joelrader/linux-business-card/readme.md

# linux-business-card
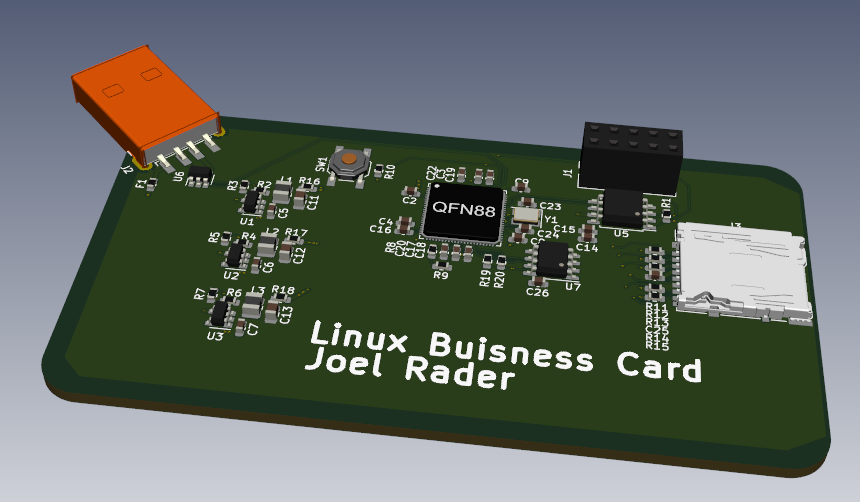
[picture p1: media/board.png]


A business card that runs Linux! It has a strong focus on security and privacy.

## Components
- F1C100s is the main application processor
- ATECC608A used as the crypto chip
- Micro SD card slot
- Flash memory
