joelrader/linux-business-card/electronics/readme.md

# Electrical Design
The main AP is an Allwinner F1C100s.

## Power Rails

VCC-IO: 3.3V @ ?A
TV_AVCC: 3.3V @ ?A
Avcc: 2.8V @ ?A
VCC_DRAM: 2.5V @ ?A
VDD_CORE: 1.1V @ ?A

## Components
SMPS
    - JW5211
        - Looks decent
