joelrader/linux-business-card/electronics/board/step/QFN88.stp

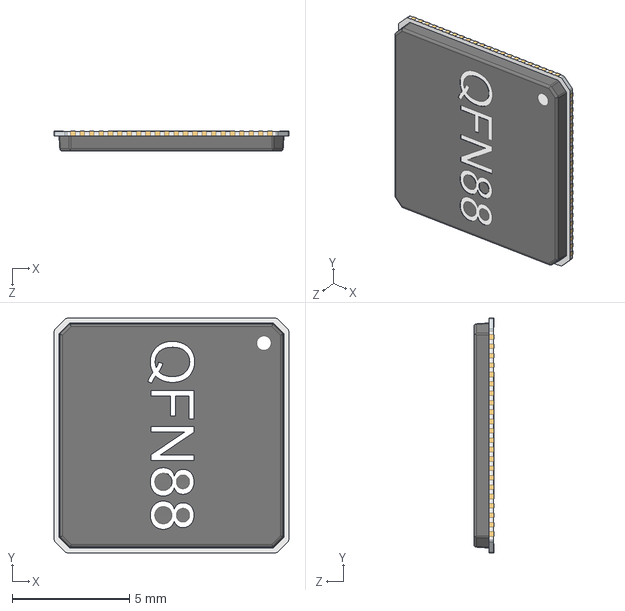
[picture p2: CAD file, 2021-07-21]
electronics/board/step/QFN88.stp
10.0 x 10.0 x 0.87 mm
