joelrader/linux-business-card/electronics/board/step/DM3AT-SF-PEJM5.stp

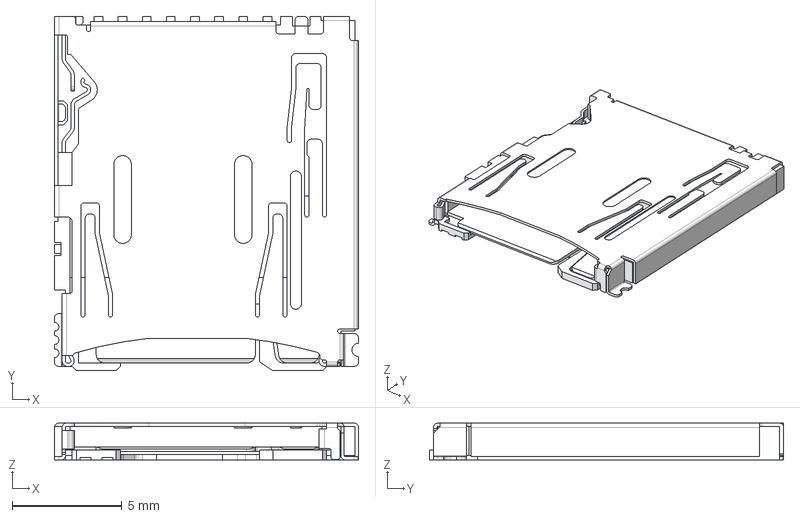
[picture p3: CAD file, 2021-07-21]
electronics/board/step/DM3AT-SF-PEJM5.stp
13.8 x 16.2 x 1.68 mm
