joelrader/linux-business-card/electronics/board/step/1001-011-01101.igs

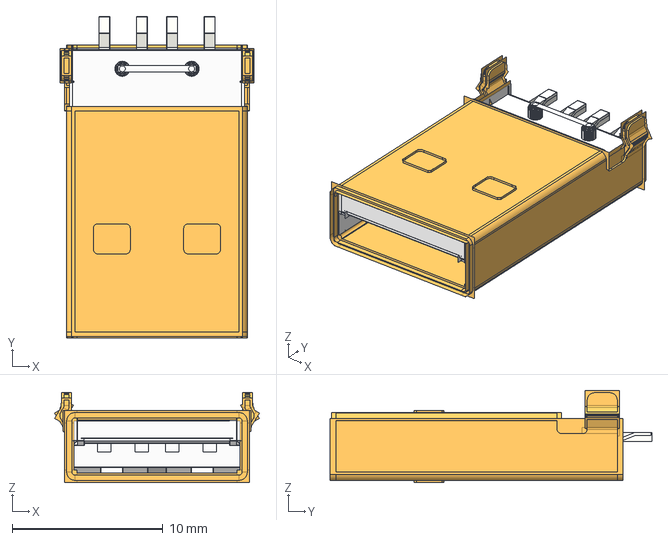
[picture p4: CAD file, 2021-07-21]
electronics/board/step/1001-011-01101.igs
13.6 x 21.4 x 6.12 mm
