joelrader/linux-business-card/electronics/board/board.kicad_pcb

## KiCad design electronics/board/board.kicad_pcb (2021-07-27)

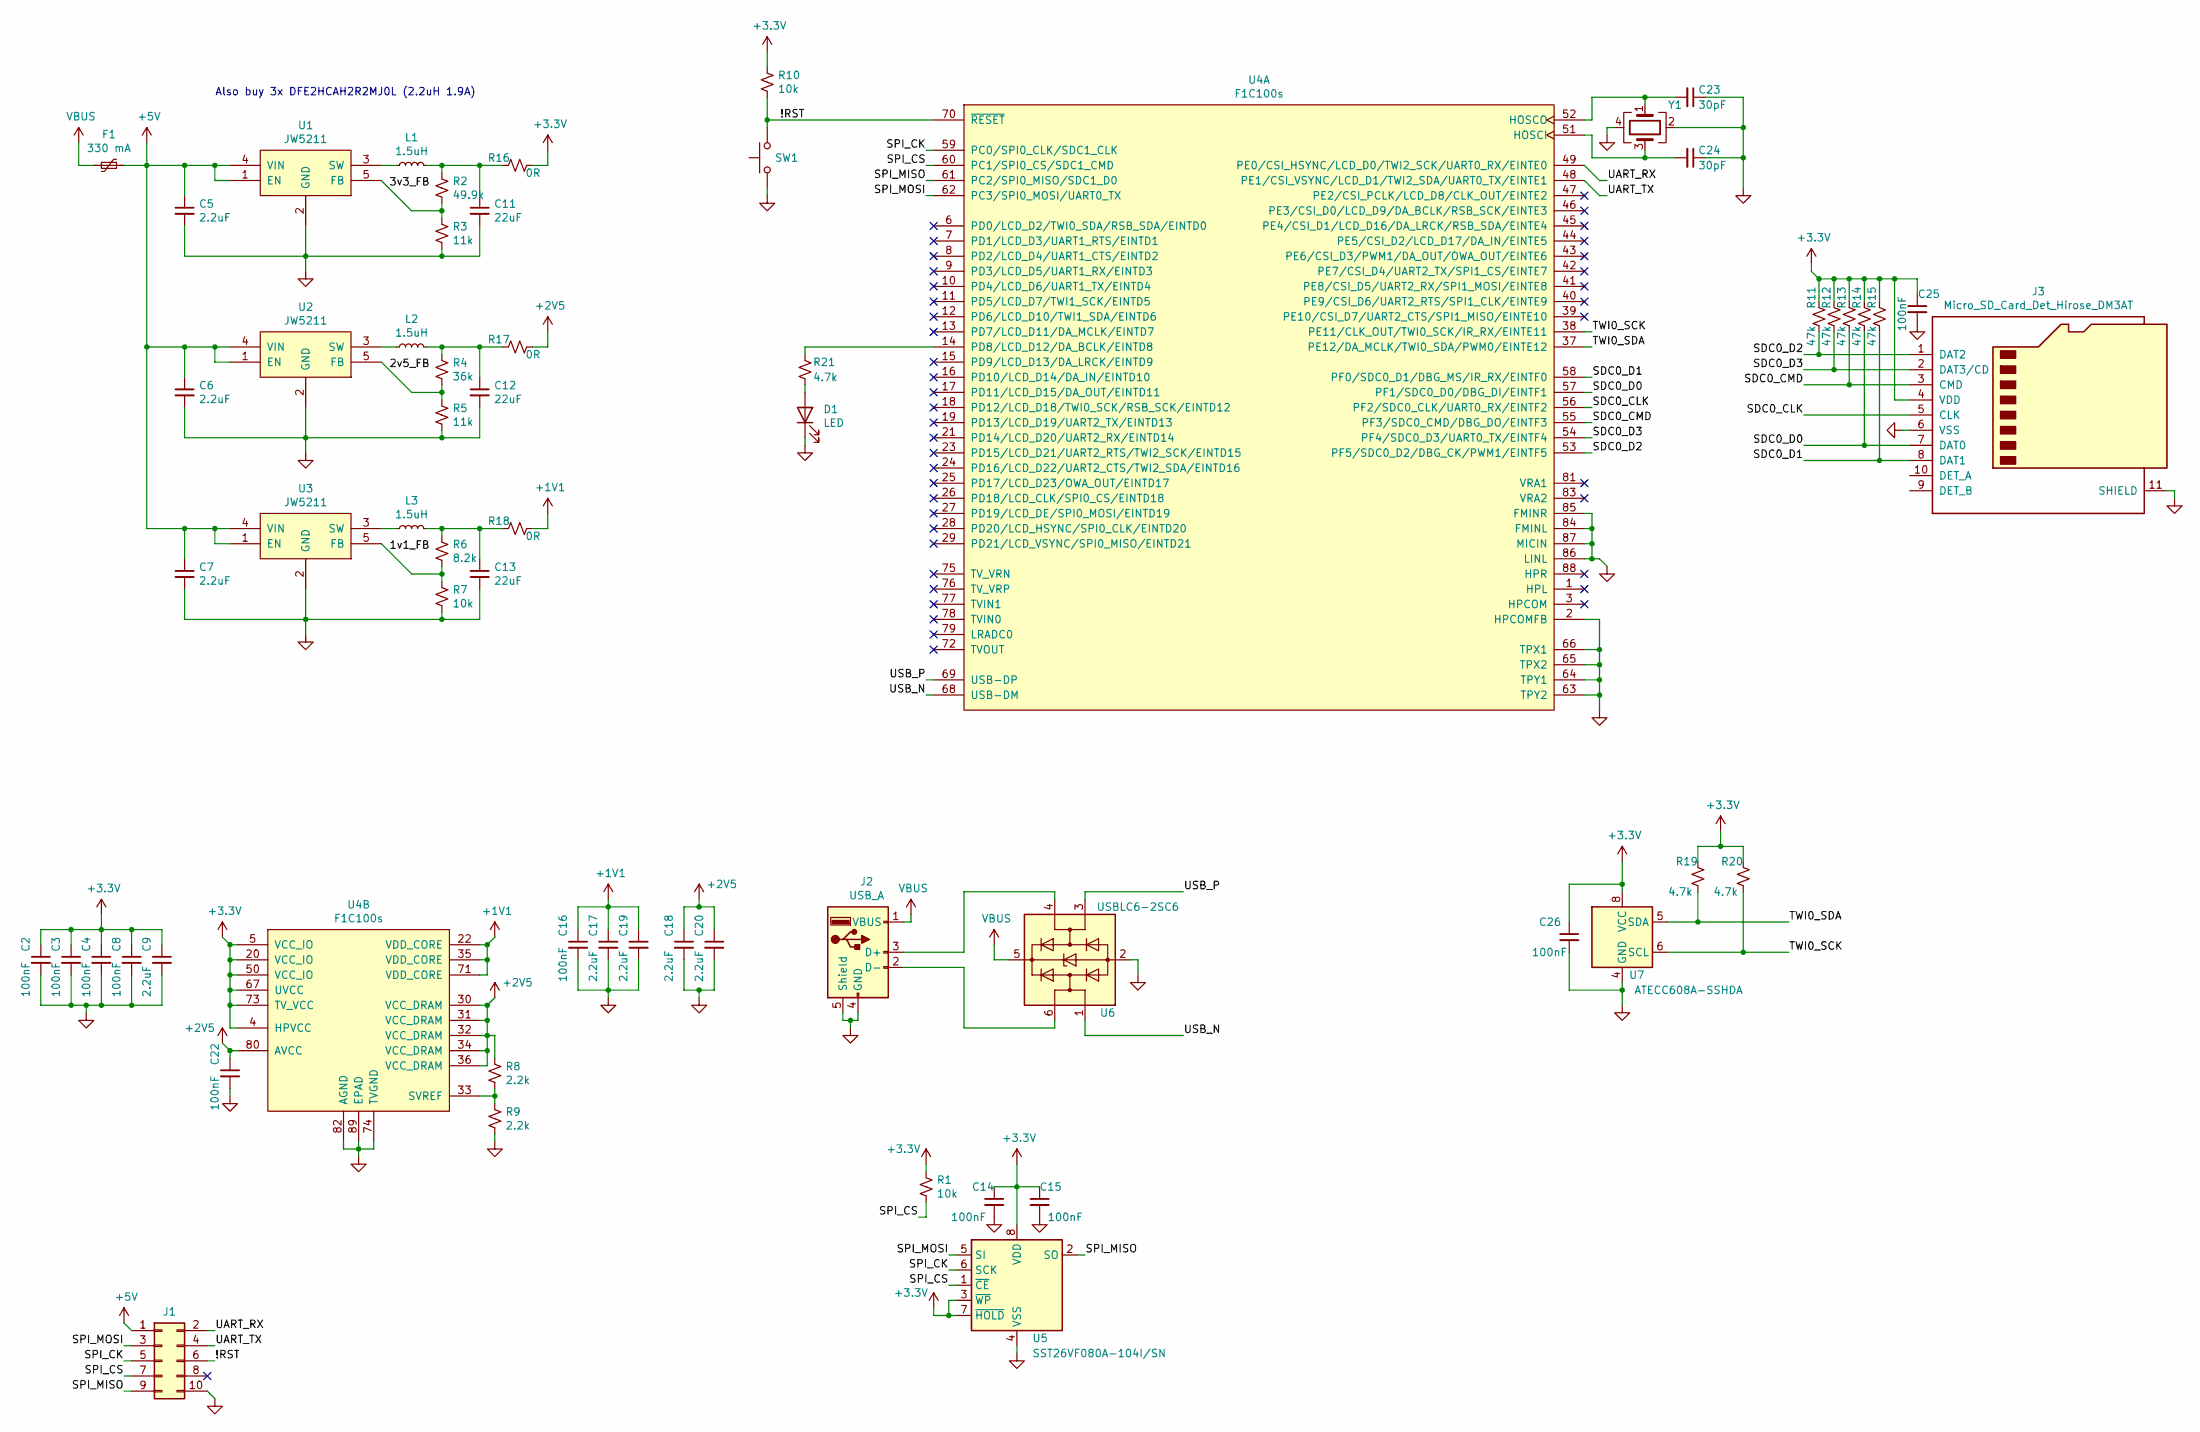
[picture p5: schematic board.sch, Linux Buisness Card]

Parts:
C2, C3, C4, C8, C14, C15, C16, C25, C26: 100nF; C_0603_1608Metric; MPN C0603X7R250-104KNP
C5, C6, C7, C9, C17, C18, C19, C20: 2.2uF; C_0603_1608Metric; MPN CL10A225KP8NNNC
C11, C12, C13: 22uF; C_0805_2012Metric; MPN GRM188R60J226MEA0D
C22: 100nF; C_0603_1608Metric
C23, C24: 30pF; C_0603_1608Metric; MPN GRM1885C1H300JA01D
D1: LED; LED_0603_1608Metric; MPN APT1608CGCK
F1: 330 mA; Fuse_0603_1608Metric; MPN PRG18BC4R7MM1RB
J1: Conn_02x05_Odd_Even; PinSocket_2x05_P2.54mm_Vertical
J2: USB_A; USB_A_CNCTech_1001-011-01101_Horizontal; MPN 1001-011-01101
J3: Micro_SD_Card_Det_Hirose_DM3AT; microSD_HC_Hirose_DM3AT-SF-PEJM5; MPN DM3AT-SF-PEJM5
L1, L2, L3: 1.5uH; L_1008_2520Metric; MPN CVH252009-1R5M
R1, R10: 10k; R_0603_1608Metric; MPN RC0603FR-0710KL
R2: 49.9k; R_0603_1608Metric; MPN RC0603FR-0749K9
R3, R5: 11k; R_0603_1608Metric; MPN RC0603FR-0711K
R4: 36k; R_0603_1608Metric; MPN RC0603FR-0736K
R6: 8.2k; R_0603_1608Metric; MPN RC0603FR-078K2L
R7: 10k; R_0603_1608Metric; MPN RC0603FR-0710K
R8, R9: 2.2k; R_0603_1608Metric; MPN RC0603FR-072K2L
R11, R12, R13, R14, R15: 47k; R_0603_1608Metric; MPN RC0603FR-0747KL
R16, R17, R18: 0R; R_0603_1608Metric; MPN RC0603FR-070RL
R19, R20, R21: 4.7k; R_0603_1608Metric; MPN RC0603FR-074K7L
SW1: SW_Push; SW_SPST_TL3342; MPN TL3342F450QG
U1, U2, U3: JW5211; SOT-23-5; MPN JW5211
U4: F1C100s; QFN-88_EP_10x10_Pitch0.4mm; MPN F1C100s
U5: SST26VF080A-104I/SN; SOIC-8_5.275x5.275mm_P1.27mm; MPN SST26VF080A-104I/SN
U6: USBLC6-2SC6; SOT-23-6; MPN USBLC6-2SC6
U7: ATECC608A-SSHDA; SOIC-8_3.9x4.9mm_P1.27mm; MPN ATECC608A-SSHDA
Y1: Crystal_GND24; Crystal_SMD_Abracon_ABM8G-4Pin_3.2x2.5mm; MPN ABM8G-24.000MHZ-18-D2Y-T

Connections:
+1V1: C16.1, C17.1, C19.1, R18.1, U4.22 (VDD_CORE), U4.35 (VDD_CORE), U4.71 (VDD_CORE)
+2V5: C18.1, C20.1, C22.1, R8.1, R17.1, U4.30 (VCC_DRAM), U4.31 (VCC_DRAM), U4.32 (VCC_DRAM), U4.34 (VCC_DRAM), U4.36 (VCC_DRAM), U4.80 (AVCC)
+3V3: C2.1, C3.1, C4.1, C8.1, C9.1, C14.1, C15.1, C25.1, C26.1, J3.4 (VDD), R1.1, R10.1, R11.1, R12.1, R13.1, R14.1, R15.1, R16.1, R19.1, R20.1, U4.4 (HPVCC), U4.5 (VCC_IO), U4.20 (VCC_IO), U4.50 (VCC_IO), U4.67 (UVCC), U4.73 (TV_VCC), U5.3 (~WP~), U5.7 (~HOLD~), U5.8 (VDD), U7.8 (VCC)
+5V: C5.1, C6.1, C7.1, F1.1, J1.1, U1.1 (EN), U1.4 (VIN), U2.1 (EN), U2.4 (VIN), U3.1 (EN), U3.4 (VIN)
/1v1_FB: R6.2, R7.1, U3.5 (FB)
/2v5_FB: R4.2, R5.1, U2.5 (FB)
/3v3_FB: R2.2, R3.1, U1.5 (FB)
/!RST: J1.6, R10.2, SW1.2, U4.70 (~RESET)
/SDC0_CLK: J3.5 (CLK), U4.56 (PF2/SDC0_CLK/UART0_RX/EINTF2)
/SDC0_CMD: J3.3 (CMD), R13.2, U4.55 (PF3/SDC0_CMD/DBG_DO/EINTF3)
/SDC0_D0: J3.7 (DAT0), R14.2, U4.57 (PF1/SDC0_D0/DBG_DI/EINTF1)
/SDC0_D1: J3.8 (DAT1), R15.2, U4.58 (PF0/SDC0_D1/DBG_MS/IR_RX/EINTF0)
/SDC0_D2: J3.1 (DAT2), R11.2, U4.53 (PF5/SDC0_D2/DBG_CK/PWM1/EINTF5)
/SDC0_D3: J3.2 (DAT3/CD), R12.2, U4.54 (PF4/SDC0_D3/UART0_TX/EINTF4)
/SPI_CK: J1.5, U4.59 (PC0/SPI0_CLK/SDC1_CLK), U5.6 (SCK)
/SPI_CS: J1.7, R1.2, U4.60 (PC1/SPI0_CS/SDC1_CMD), U5.1 (~CE)
/SPI_MISO: J1.9, U4.61 (PC2/SPI0_MISO/SDC1_D0), U5.2 (SO)
/SPI_MOSI: J1.3, U4.62 (PC3/SPI0_MOSI/UART0_TX), U5.5 (SI)
/TWI0_SCK: R20.2, U4.38 (PE11/CLK_OUT/TWI0_SCK/IR_RX/EINTE11), U7.6 (SCL)
/TWI0_SDA: R19.2, U4.37 (PE12/DA_MCLK/TWI0_SDA/PWM0/EINTE12), U7.5 (SDA)
/UART_RX: J1.2, U4.49 (PE0/CSI_HSYNC/LCD_D0/TWI2_SCK/UART0_RX/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)
/UART_TX: J1.4, U4.48 (PE1/CSI_VSYNC/LCD_D1/TWI2_SDA/UART0_TX/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)
/USB_N: U4.68 (USB-DM), U6.1 (I/O1)
/USB_P: U4.69 (USB-DP), U6.3 (I/O2)
GND: C2.2, C3.2, C4.2, C5.2, C6.2, C7.2, C8.2, C9.2, C11.2, C12.2, C13.2, C14.2, C15.2, C16.2, C17.2, C18.2, C19.2, C20.2, C22.2, C23.1, C24.1, C25.2, C26.2, D1.1 (K), J1.10, J2.4 (GND), J2.5 (Shield), J3.6 (VSS), J3.11 (SHIELD), R3.2, R5.2, R7.2, R9.2, SW1.1, U1.2 (GND), U2.2 (GND), U3.2 (GND), U4.2 (HPCOMFB), U4.63 (TPY2), U4.64 (TPY1), U4.65 (TPX2), U4.66 (TPX1), U4.74 (TVGND), U4.82 (AGND), U4.84 (FMINL), U4.85 (FMINR), U4.86 (LINL), U4.87 (MICIN), U4.89 (EPAD), U5.4 (VSS), U6.2 (GND), U7.4 (GND), Y1.2, Y1.4
unnamed: C11.1, L1.2, R2.1, R16.2
unnamed: C12.1, L2.2, R4.1, R17.2
unnamed: C13.1, L3.2, R6.1, R18.2
unnamed: C23.2, U4.52 (HOSCO), Y1.1
unnamed: C24.2, U4.51 (HOSCI), Y1.3
unnamed: D1.2 (A), R21.2
unnamed: J2.2 (D-), U6.6 (I/O1)
unnamed: J2.3 (D+), U6.4 (I/O2)
unnamed: L1.1, U1.3 (SW)
unnamed: L2.1, U2.3 (SW)
unnamed: L3.1, U3.3 (SW)
unnamed: R8.2, R9.1, U4.33 (SVREF)
unnamed: R21.1, U4.14 (PD8/LCD_D12/DA_BCLK/EINTD8)
VBUS: F1.2, J2.1 (VBUS), U6.5 (VBUS)

Notes on the sheet:
Also buy 3x DFE2HCAH2R2MJ0L (2.2uH 1.9A)

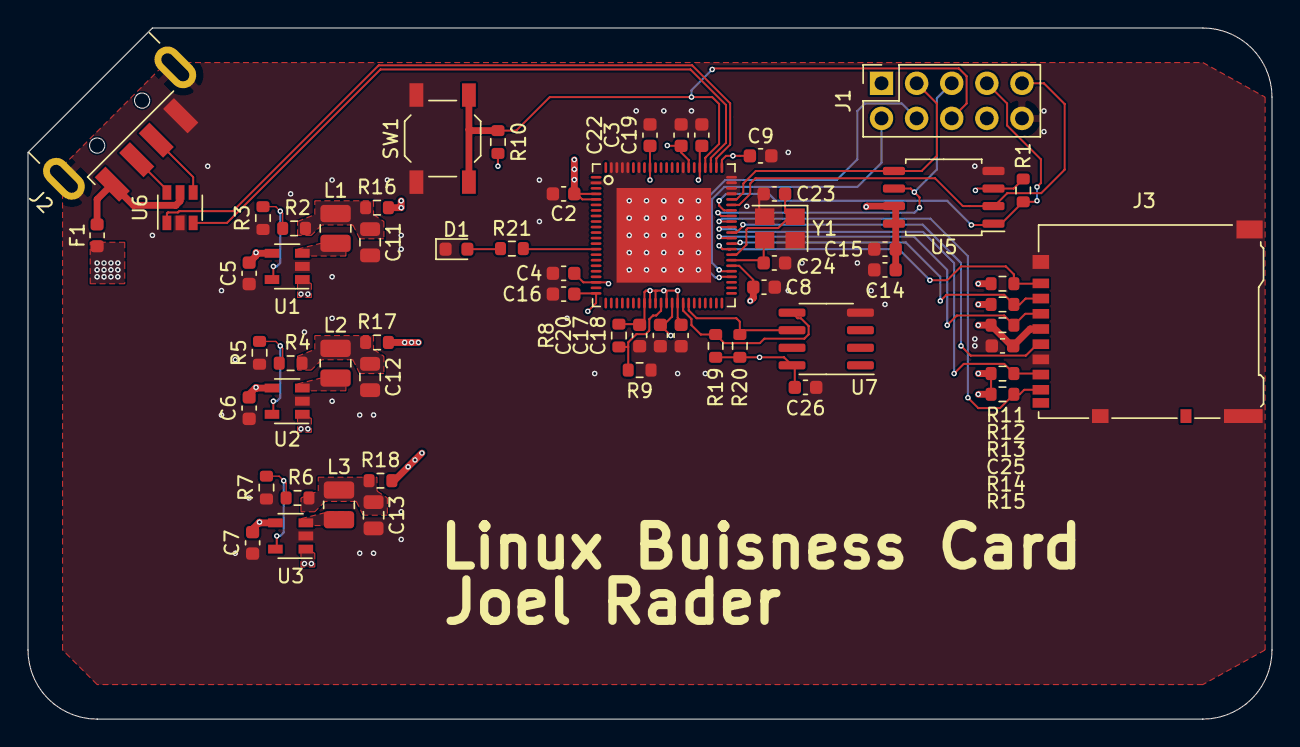
[picture p6: board board.kicad_pcb from above]

Board: 4 copper layers, 90.0 x 50.0 mm, 61 parts (0 on the bottom side), 39 nets.
