joelrader/linux-business-card/(commit log)

2021-06-29 Initial commit, AP dropped in, added some datasheets.
    [board.kicad_pcb, board.sch]
2021-07-02 Added some components and studied some datasheets.
    [board.sch]
2021-07-02 Dropped in the power supplies and hooked up the AP.
    [board.sch]
2021-07-05 Flash in, header in, UART in, Crystal in. Wired up most of the board.
    [board.sch]
2021-07-14 Added user manual, dropped in SD card holder into schematic.
    [board.sch]
2021-07-14 Selected inductors.
    [board.sch]
2021-07-14 Added USB power protection, started adding package footprints.
    [board.sch]
2021-07-14 Added ATECC608B security chip and filled in the rest of footprints.
    [board.sch]
2021-07-14 Dropped all the part on the board.
    [board.kicad_pcb]
2021-07-21 Arranged the parts.
    [board.kicad_pcb, board.sch]
2021-07-21 Dropped in the 3d models and outlined the board.
    [1001-011-01101.igs, DM3AT-SF-PEJM5.stp, QFN88.stp, board.kicad_pcb]
2021-07-23 Started the main routing.
    [board.kicad_pcb]
2021-07-23 Nearly finished up all the layout, power distrobution done. Just a couple more nets to connect up and silk.
    [board.kicad_pcb, board.sch]
2021-07-27 Layout finished, added some images.
    [board.kicad_pcb, board.sch]
2021-07-27 Filled in the rest of the part numbers, generated a bom.
    [board.kicad_pcb, board.sch]
